bo-aryan/custom-keeb/(commit log)

2026-09-07 Update JOURNAL.md with September 7 entry
    Documented progress on RGB LEDs and mechanical setup, including schematic updates and next steps.
2026-09-08 Revise JOURNAL.md with latest design updates
    Updated journal entries for PCB design progress, including schematic and layout details.
2026-09-09 Update JOURNAL with PCB routing progress
    Continued routing the PCB in KiCad, completing various connections and verifying routing.
2026-09-10 Update JOURNAL.md with September 10, 2026 entry
    Documented progress on PCB routing and DRC issues.
2026-10-10 Revise JOURNAL.md with recent PCB updates
    Updated journal entries with progress on PCB design and routing. Corrected previous notes and outlined next steps for the project.
2026-10-30 Rename custom keeb.kicad_sch to hardware/custom keeb.kicad_sch
2026-10-30 Rename custom keeb.kicad_pcb to hardware/custom keeb.kicad_pcb
2026-10-30 Rename custom keeb.kicad_pro to hardware/custom keeb.kicad_pro
2026-10-30 Rename custom keeb-gerbers 1.zip to hadware/custom keeb-gerbers 1.zip
2026-10-30 Add case design section to README
    Added a section on case design with details about the enclosure and its features.
2026-10-30 Revise README with project overview and learnings
    Updated the README to reflect project details, learning outcomes, and key engineering decisions for the custom 8-key mechanical macropad. Added sections on functionality, PCB design, and final results.
2026-10-30 Document assembly challenges and debugging issues
    Added section on assembly challenges and electrical debugging, detailing issues with OLED footprint, ground connections, damaged RGB LEDs, and hot-swap socket placement.
2026-10-30 Revise switch matrix and LED configurations
    Updated the switch matrix and LED configurations in the PCB design. Adjusted the number of switches and LEDs, and refined the routing and assembly processes.
